AngasT/RemoraMIDI/Hardware/RemoraPico.kicad_sch

## KiCad design Hardware/RemoraPico.kicad_sch (2025-09-03)

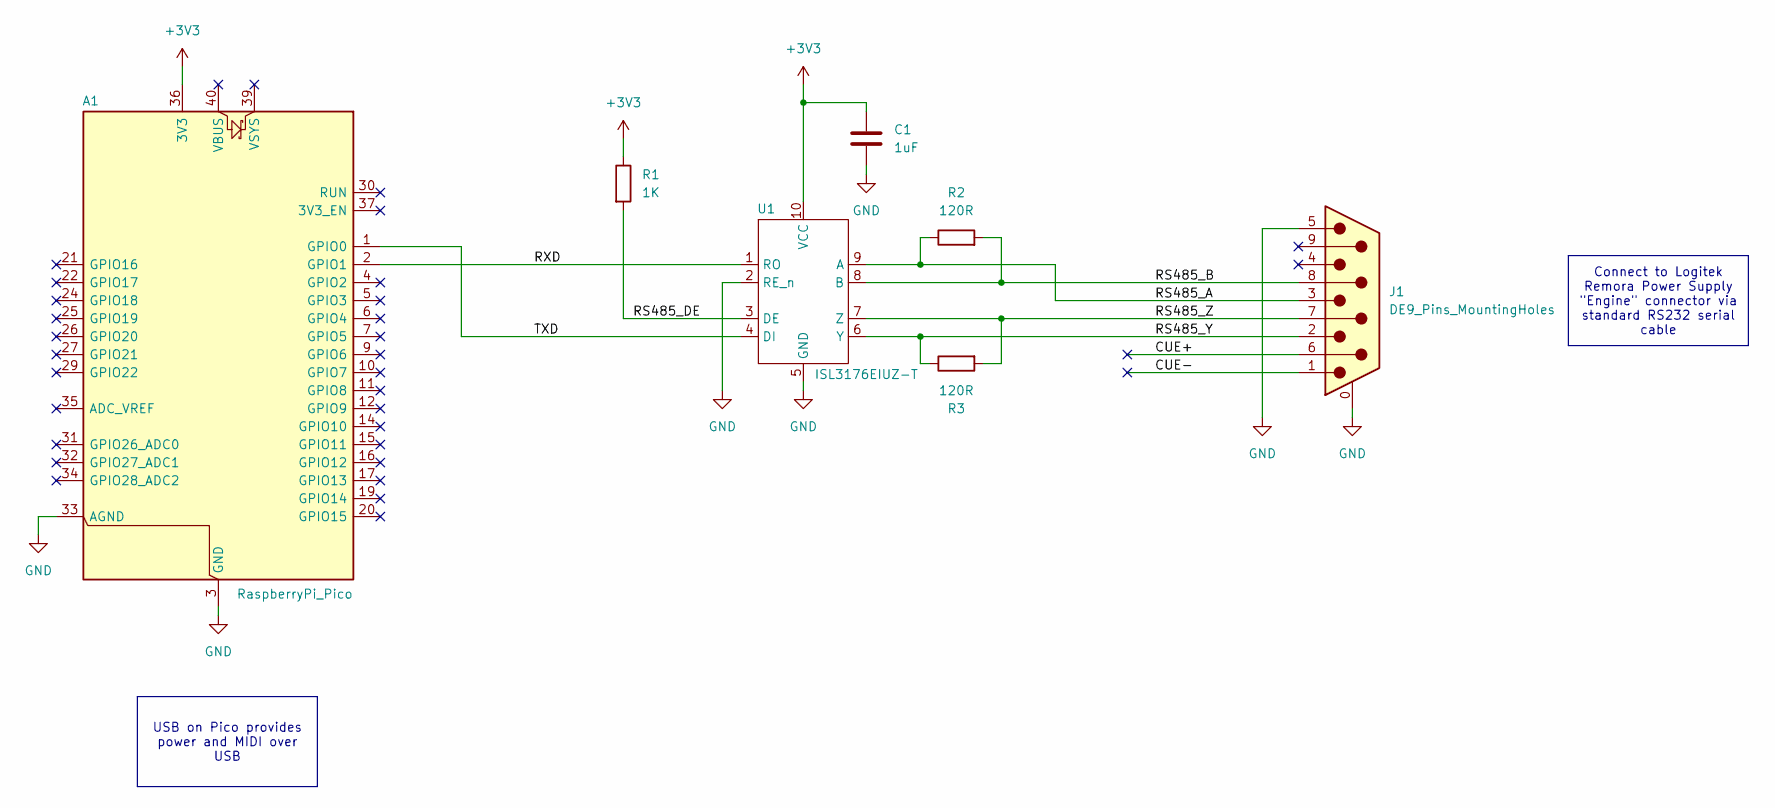
[picture p1: schematic RemoraPico.kicad_sch]

Parts:
A1: RaspberryPi_Pico; RaspberryPi_Pico_Common_Unspecified
C1: 1uF; C_0603_1608Metric
J1: DE9_Pins_MountingHoles; DSUB-9_Pins_Horizontal_P2.77x2.84mm_EdgePinOffset7.70mm_Hou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
R1: 1K; R_0603_1608Metric
R2, R3: 120R; R_0603_1608Metric
U1: ISL3176EIUZ-T; 10-MSOP

Connections:
+3V3: A1.36 (3V3), C1.1, R1.1, U1.10 (VCC)
CUE+: J1.6
CUE-: J1.1
GND: A1.3 (GND), A1.8 (GND), A1.13 (GND), A1.18 (GND), A1.23 (GND), A1.28 (GND), A1.33 (AGND), A1.38 (GND), C1.2, J1.0 (PAD), J1.5, U1.2 (RE_n), U1.5 (GND)
RS485_A: J1.3, R2.1, U1.9 (A)
RS485_B: J1.8, R2.2, U1.8 (B)
RS485_DE: R1.2, U1.3 (DE)
RS485_Y: J1.2, R3.1, U1.6 (Y)
RS485_Z: J1.7, R3.2, U1.7 (Z)
RXD: A1.2 (GPIO1), U1.1 (RO)
TXD: A1.1 (GPIO0), U1.4 (DI)

Notes on the sheet:
USB on Pico provides power and MIDI over USB
Connect to Logitek Remora Power Supply "Engine" connector via standard RS232 serial cable
