AngasT/RemoraMIDI/MackieControlUniversal.py

#Predefined midi notes for Mackie Control compatibility
protocol = {'REC_RDY_CH1': 0x00,
       'REC_RDY_CH2': 0x01,
       'REC_RDY_CH3': 0x02,
       'REC_RDY_CH4': 0x03,
       'REC_RDY_CH5': 0x04,
       'REC_RDY_CH6': 0x05,
       'REC_RDY_CH7': 0x06,
       'REC_RDY_CH8': 0x07,
       'SOLO_CH1': 0x08,
       'SOLO_CH2': 0x09,
       'SOLO_CH3': 0x0A,
       'SOLO_CH4': 0x0B,
       'SOLO_CH5': 0x0C,
       'SOLO_CH6': 0x0D,
       'SOLO_CH7': 0x0E,
       'SOLO_CH8': 0x0F,
       'MUTE_CH1': 0x10,
       'MUTE_CH2': 0x11,
       'MUTE_CH3': 0x12,
       'MUTE_CH4': 0x13,
       'MUTE_CH5': 0x14,
       'MUTE_CH6': 0x15,
       'MUTE_CH7': 0x16,
       'MUTE_CH8': 0x17,
       'SELECT_CH1': 0x18,
       'SELECT_CH2': 0x19,
       'SELECT_CH3': 0x1A,
       'SELECT_CH4': 0x1B,
       'SELECT_CH5': 0x1C,
       'SELECT_CH6': 0x1D,
       'SELECT_CH7': 0x1E,
       'SELECT_CH8': 0x1F,
       'VPOT_SEL_CH1': 0x20,
       'VPOT_SEL_CH2': 0x21,
       'VPOT_SEL_CH3': 0x22,
       'VPOT_SEL_CH4': 0x23,
       'VPOT_SEL_CH5': 0x24,
       'VPOT_SEL_CH6': 0x25,
       'VPOT_SEL_CH7': 0x26,
       'VPOT_SEL_CH8': 0x27,
       'ASSIGN_TRACK': 0x28,
       'ASSIGN_SEND': 0x29,
       'ASSIGN_PAN': 0x2A,
       'ASSIGN_PLUGIN': 0x2B,
       'ASSIGN_EQ': 0x2C,
       'ASSIGN_INSTR': 0x2D,
       'BANK_LEFT': 0x2E,
       'BANK_RIGHT': 0x2F,
       'CHANNEL_LEFT': 0x30,
       'CHANNEL_RIGHT': 0x31,
       'FLIP': 0x32,
       'GLOBAL_VIEW': 0x33,
       'NAME_VALUE': 0x34,
       'SMPTE_BEATS': 0x35,
       'F1': 0x36,
       'F2': 0x37,
       'F3': 0x38,
       'F4': 0x39,
       'F5': 0x3A,
       'F6': 0x3B,
       'F7': 0x3C,
       'F8': 0x3D,
       'VIEW_MIDI': 0x3E,
       'VIEW_INPUTS': 0x3F,
       'VIEW_AUDIO': 0x40,
       'VIEW_INSTR': 0x41,
       'VIEW_AUX': 0x42,
       'VIEW_BUSSES': 0x43,
       'VIEW_OUTPUTS': 0x44,
       'VIEW_USER': 0x45,
       'SHIFT': 0x46,
       'OPTION': 0x47,
       'CONTROL': 0x48,
       'CMD_ALT': 0x49,
       'AUTOMATION_READ_OFF': 0x4A,
       'AUTOMATION_WRITE': 0x4B,
       'AUTOMATION_TRIM': 0x4C,
       'AUTOMATION_TOUCH': 0x4D,
       'AUTOMATION_LATCH': 0x4E,
       'GROUP': 0x4F,
       'SAVE': 0x50,
       'UNDO': 0x51,
       'CANCEL': 0x52,
       'ENTER': 0x53,
       'MARKER': 0x54,
       'NUDGE': 0x55,
       'CYCLE': 0x56,
       'DROP': 0x57,
       'REPLACE': 0x58,
       'CLICK': 0x59,
       'SOLO': 0x5A,
       'REWIND': 0x5B,
       'FAST_FWD': 0x5C,
       'STOP': 0x5D,
       'PLAY': 0x5E,
       'RECORD': 0x5F,
       'UP': 0x60,
       'DOWN': 0x61,
       'LEFT': 0x62,
       'RIGHT': 0x63,
       'ZOOM': 0x64,
       'SCRUB': 0x65,
       'USER_SWITCH_A': 0x66,
       'USER_SWITCH_B': 0x67,
       'FADER_TOUCH_CH1': 0x68,
       'FADER_TOUCH_CH2': 0x69,
       'FADER_TOUCH_CH3': 0x6A,
       'FADER_TOUCH_CH4': 0x6B,
       'FADER_TOUCH_CH5': 0x6C,
       'FADER_TOUCH_CH6': 0x6D,
       'FADER_TOUCH_CH7': 0x6E,
       'FADER_TOUCH_CH8': 0x6F,
       'FADER_TOUCH_MASTER': 0x70,
       'SMPTE': 0x71,
       'BEATS': 0x72,
       'RUDE_SOLO': 0x73,
       'RELAY': 0x76,
}

#custom mapping between Remora buttons and MCU functionality
mapping = {'CH1_PLAY_STOP': 'MUTE_CH1',
            'CH1_P_BUTTON': 'REC_RDY_CH1',
            'CH1_CUE_BUTTON': 'SOLO_CH1',
            'CH1_1_BUTTON': 'SELECT_CH1',
            'CH1_2_BUTTON': 'VPOT_SEL_CH1',
            'CH1_3_BUTTON': 'FADER_TOUCH_CH1',
            'CH1_TB_BUTTON': 'PLAY',
           'CH2_PLAY_STOP': 'MUTE_CH2',
            'CH2_P_BUTTON': 'REC_RDY_CH2',
            'CH2_CUE_BUTTON': 'SOLO_CH2',
            'CH2_1_BUTTON': 'SELECT_CH2',
            'CH2_2_BUTTON': 'VPOT_SEL_CH2',
            'CH2_3_BUTTON': 'FADER_TOUCH_CH2',
            'CH2_TB_BUTTON': 'PLAY',
           'CH3_PLAY_STOP': 'MUTE_CH3',
            'CH3_P_BUTTON': 'REC_RDY_CH3',
            'CH3_CUE_BUTTON': 'SOLO_CH3',
            'CH3_1_BUTTON': 'SELECT_CH3',
            'CH3_2_BUTTON': 'VPOT_SEL_CH3',
            'CH3_3_BUTTON': 'FADER_TOUCH_CH3',
            'CH3_TB_BUTTON': 'PLAY',
           'CH4_PLAY_STOP': 'MUTE_CH4',
            'CH4_P_BUTTON': 'REC_RDY_CH4',
            'CH4_CUE_BUTTON': 'SOLO_CH4',
            'CH4_1_BUTTON': 'SELECT_CH4',
            'CH4_2_BUTTON': 'VPOT_SEL_CH4',
            'CH4_3_BUTTON': 'FADER_TOUCH_CH4',
            'CH4_TB_BUTTON': 'PLAY',
           'CH5_PLAY_STOP': 'MUTE_CH5',
            'CH5_P_BUTTON': 'REC_RDY_CH5',
            'CH5_CUE_BUTTON': 'SOLO_CH5',
            'CH5_1_BUTTON': 'SELECT_CH5',
            'CH5_2_BUTTON': 'VPOT_SEL_CH5',
            'CH5_3_BUTTON': 'FADER_TOUCH_CH5',
            'CH5_TB_BUTTON': 'PLAY',
           'CH6_PLAY_STOP': 'MUTE_CH6',
            'CH6_P_BUTTON': 'REC_RDY_CH6',
            'CH6_CUE_BUTTON': 'SOLO_CH6',
            'CH6_1_BUTTON': 'SELECT_CH6',
            'CH6_2_BUTTON': 'VPOT_SEL_CH6',
            'CH6_3_BUTTON': 'FADER_TOUCH_CH6',
            'CH6_TB_BUTTON': 'PLAY',
           'CH7_PLAY_STOP': 'MUTE_CH7',
            'CH7_P_BUTTON': 'REC_RDY_CH7',
            'CH7_CUE_BUTTON': 'SOLO_CH7',
            'CH7_1_BUTTON': 'SELECT_CH7',
            'CH7_2_BUTTON': 'VPOT_SEL_CH7',
            'CH7_3_BUTTON': 'FADER_TOUCH_CH7',
            'CH7_TB_BUTTON': 'PLAY',
           'CH8_PLAY_STOP': 'MUTE_CH8',
            'CH8_P_BUTTON': 'REC_RDY_CH8',
            'CH8_CUE_BUTTON': 'SOLO_CH8',
            'CH8_1_BUTTON': 'SELECT_CH8',
            'CH8_2_BUTTON': 'VPOT_SEL_CH8',
            'CH8_3_BUTTON': 'FADER_TOUCH_CH8',
            'CH8_TB_BUTTON': 'PLAY',
           'CH9_PLAY_STOP': 'PLAY',
            'CH9_P_BUTTON': 'RECORD',
            'CH9_CUE_BUTTON': 'PLAY',
            'CH9_1_BUTTON': 'PLAY',
            'CH9_2_BUTTON': 'PLAY',
            'CH9_3_BUTTON': 'FADER_TOUCH_MASTER',
            'CH9_TB_BUTTON': 'PLAY',
           'CH10_PLAY_STOP': 'MUTE_CH',
            'CH10_P_BUTTON': 'REC_RDY_CH',
            'CH10_CUE_BUTTON': 'SOLO_CH',
            'CH10_1_BUTTON': 'SELECT_CH',
            'CH10_2_BUTTON': 'VPOT_SEL_CH',
            'CH10_3_BUTTON': 'FADER_TOUCH_CH',
            'CH10_TB_BUTTON': 'PLAY',
            'BRIDGE1': 'PLAY',
            'BRIDGE2': 'STOP',
            'BRIDGE3': 'REWIND',
            'BRIDGE4': 'FAST_FWD',
            'BRIDGE5': 'RECORD',
            'BRIDGE6': 'UP',
            'BRIDGE7': 'DOWN',
            'BRIDGE8': 'ENTER',
            'BRIDGE9': 'LEFT',
            'BRIDGE10': 'RIGHT',
            'BRIDGE11': 'UNDO',
            'BRIDGE12': 'CANCEL',
            'SOFTKEY1': 'ASSIGN_TRACK',
            'SOFTKEY2': 'ASSIGN_SEND',
            'SOFTKEY3': 'ASSIGN_PAN',
            'SOFTKEY4': 'ASSIGN_PLUGIN',
            'SOFTKEY5': 'ASSIGN_EQ',
            'SOFTKEY6': 'ASSIGN_INSTR',
            'SOFTKEY7': 'CHANNEL_LEFT',
            'SOFTKEY8': 'CHANNEL_RIGHT',
            'SOFTKEY9': 'FLIP',
            'SOFTKEY10': 'GLOBAL_VIEW',
            'SOFTKEY11': 'NAME_VALUE',
            'SOFTKEY12': 'SMPTE_BEATS',
            'SOFTKEY13': 'F1',
            'SOFTKEY14': 'F2',
            'SOFTKEY15': 'F3',
            'SOFTKEY16': 'F4',
            'SOFTKEY17': 'F5',
            'SOFTKEY18': 'F6',
            'SOFTKEY19': 'F7',
            'SOFTKEY20': 'F8',
            'SOFTKEY21': 'ENTER',
            'SOFTKEY22': 'MARKER',
            'SOFTKEY23': 'BANK_LEFT',
            'SOFTKEY24': 'BANK_RIGHT',
}
