AngasT/RemoraMIDI/Remora.py

#Button BusIDs on Remora Control Surface
ch1 = {0x00: 'CH1_PLAY_STOP',
              0x01: 'CH1_P_BUTTON',
              0x02: 'CH1_CUE_BUTTON',
              0x03: 'CH1_1_BUTTON',
              0x04: 'CH1_2_BUTTON',
              0x05: 'CH1_3_BUTTON',
              0x0E: 'CH1_TB_BUTTON',
}

ch2 = {0x00: 'CH2_PLAY_STOP',
              0x01: 'CH2_P_BUTTON',
              0x02: 'CH2_CUE_BUTTON',
              0x03: 'CH2_1_BUTTON',
              0x04: 'CH2_2_BUTTON',
              0x05: 'CH2_3_BUTTON',
              0x0E: 'CH2_TB_BUTTON',
}

ch3 = {0x00: 'CH3_PLAY_STOP',
              0x01: 'CH3_P_BUTTON',
              0x02: 'CH3_CUE_BUTTON',
              0x03: 'CH3_1_BUTTON',
              0x04: 'CH3_2_BUTTON',
              0x05: 'CH3_3_BUTTON',
              0x0E: 'CH3_TB_BUTTON',
}

ch4 = {0x00: 'CH4_PLAY_STOP',
              0x01: 'CH4_P_BUTTON',
              0x02: 'CH4_CUE_BUTTON',
              0x03: 'CH4_1_BUTTON',
              0x04: 'CH4_2_BUTTON',
              0x05: 'CH4_3_BUTTON',
              0x0E: 'CH4_TB_BUTTON',
}

ch5 = {0x00: 'CH5_PLAY_STOP',
              0x01: 'CH5_P_BUTTON',
              0x02: 'CH5_CUE_BUTTON',
              0x03: 'CH5_1_BUTTON',
              0x04: 'CH5_2_BUTTON',
              0x05: 'CH5_3_BUTTON',
              0x0E: 'CH5_TB_BUTTON',
}

ch6 = {0x00: 'CH6_PLAY_STOP',
              0x01: 'CH6_P_BUTTON',
              0x02: 'CH6_CUE_BUTTON',
              0x03: 'CH6_1_BUTTON',
              0x04: 'CH6_2_BUTTON',
              0x05: 'CH6_3_BUTTON',
              0x0E: 'CH6_TB_BUTTON',
}

ch7 = {0x00: 'CH7_PLAY_STOP',
              0x01: 'CH7_P_BUTTON',
              0x02: 'CH7_CUE_BUTTON',
              0x03: 'CH7_1_BUTTON',
              0x04: 'CH7_2_BUTTON',
              0x05: 'CH7_3_BUTTON',
              0x0E: 'CH7_TB_BUTTON',
}

ch8 = {0x00: 'CH8_PLAY_STOP',
              0x01: 'CH8_P_BUTTON',
              0x02: 'CH8_CUE_BUTTON',
              0x03: 'CH8_1_BUTTON',
              0x04: 'CH8_2_BUTTON',
              0x05: 'CH8_3_BUTTON',
              0x0E: 'CH8_TB_BUTTON',
}

ch9 = {0x00: 'CH9_PLAY_STOP',
              0x01: 'CH9_P_BUTTON',
              0x02: 'CH9_CUE_BUTTON',
              0x03: 'CH9_1_BUTTON',
              0x04: 'CH9_2_BUTTON',
              0x05: 'CH9_3_BUTTON',
              0x0E: 'CH9_TB_BUTTON',
}

ch10 = {0x00: 'CH10_PLAY_STOP',
              0x01: 'CH10_P_BUTTON',
              0x02: 'CH10_CUE_BUTTON',
              0x03: 'CH10_1_BUTTON',
              0x04: 'CH10_2_BUTTON',
              0x05: 'CH10_3_BUTTON',
              0x0E: 'CH10_TB_BUTTON',
}

bridge = { 0x20: 'BRIDGE1',
                  0x21: 'BRIDGE2',
                  0x22: 'BRIDGE3',
                  0x23: 'BRIDGE4',
                  0x24: 'BRIDGE5',
                  0x25: 'BRIDGE6',
                  0x26: 'BRIDGE7',
                  0x27: 'BRIDGE8',
                  0x28: 'BRIDGE9',
                  0x29: 'BRIDGE10',
                  0x2A: 'BRIDGE11',
                  0x2B: 'BRIDGE12',
}

softkeys = {0x10: 'SOFTKEY1',
                  0x11: 'SOFTKEY2',
                  0x12: 'SOFTKEY3',
                  0x13: 'SOFTKEY4',
                  0x14: 'SOFTKEY5',
                  0x15: 'SOFTKEY6',
                  0x16: 'SOFTKEY7',
                  0x17: 'SOFTKEY8',
                  0x18: 'SOFTKEY9',
                  0x19: 'SOFTKEY10',
                  0x1A: 'SOFTKEY11',
                  0x1B: 'SOFTKEY12',
                  0x1C: 'SOFTKEY13',
                  0x1D: 'SOFTKEY14',
                  0x1E: 'SOFTKEY15',
                  0x1F: 'SOFTKEY16',
                  0x20: 'SOFTKEY17',
                  0x21: 'SOFTKEY18',
                  0x22: 'SOFTKEY19',
                  0x23: 'SOFTKEY20',
                  0x24: 'SOFTKEY21',
                  0x25: 'SOFTKEY22',
                  0x26: 'SOFTKEY23',
                  0x27: 'SOFTKEY24',
}
