AngasT/RemoraMIDI/(commit log)

2025-08-14 Create code.py
    Initial commit. All channel buttons and softkeys mapped to midi notes.
2025-08-18 MCU mapping
    channel buttons now work with a single mapping.
    buttons in all used sections are functioning
2025-08-19 MCU implemented
    Moved Remora button definitions into separate file. Moved Mackie Control protocol and mapping into separate file. Should make it easier to add different protocols and alternative mappings.
    Stopped trying to be clever about grouping the same button in different channels - every button is now manually mapped individually. Simple.
2025-09-03 Added schematics and BOM
    Added hardware design files and README
